habworks/SuperStar1/Enclosure/SuperStar_PCB.stl

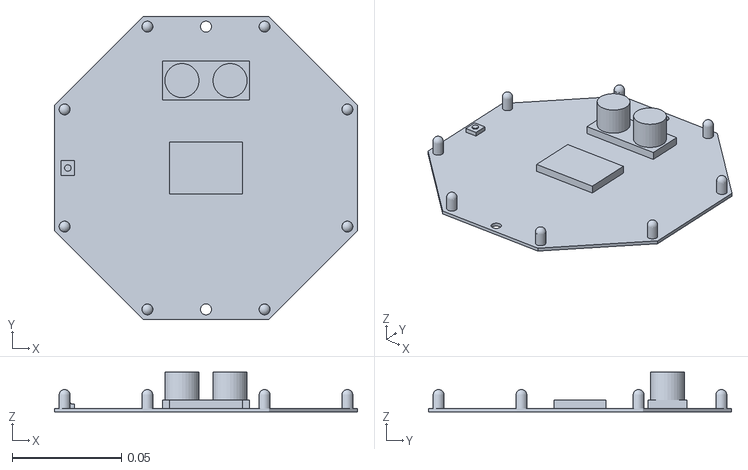
[picture p1: CAD file, 2020-10-04]
Enclosure/SuperStar_PCB.stl
0.139 x 0.139 x 0.0181
