habworks/SuperStar1/Enclosure/EnclosureBase3.stl

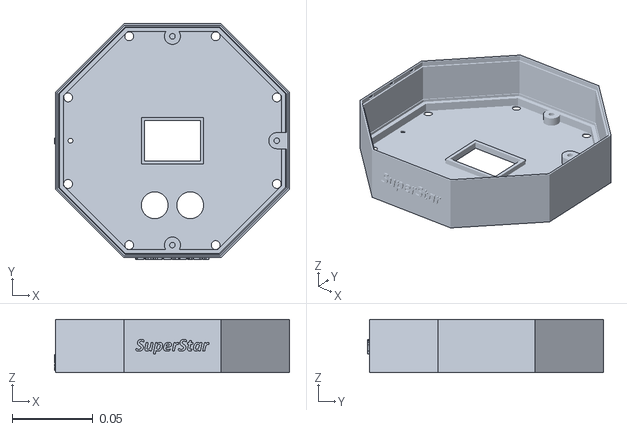
[picture p2: CAD file, 2020-10-04]
Enclosure/EnclosureBase3.stl
0.146 x 0.146 x 0.033
