habworks/SuperStar1/Enclosure/EnclosureDoor2.stl

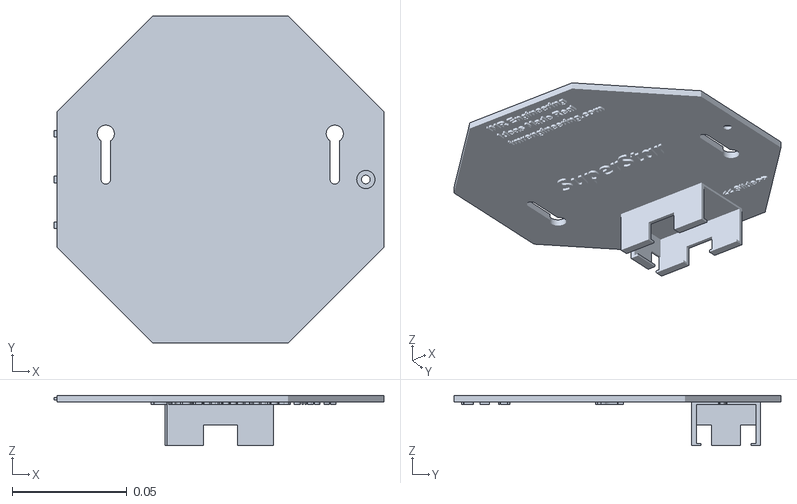
[picture p3: CAD file, 2020-10-04]
Enclosure/EnclosureDoor2.stl
0.144 x 0.143 x 0.022
