habworks/SuperStar1/(list of files, cad)

Other CAD files:
Enclosure/EnclosureBase3.blend
Enclosure/EnclosureDoor2.blend
Enclosure/SuperStar_PCB2.blend
