habworks/SuperStar1/Schematic/SUPERSTAR_SCH.PDF

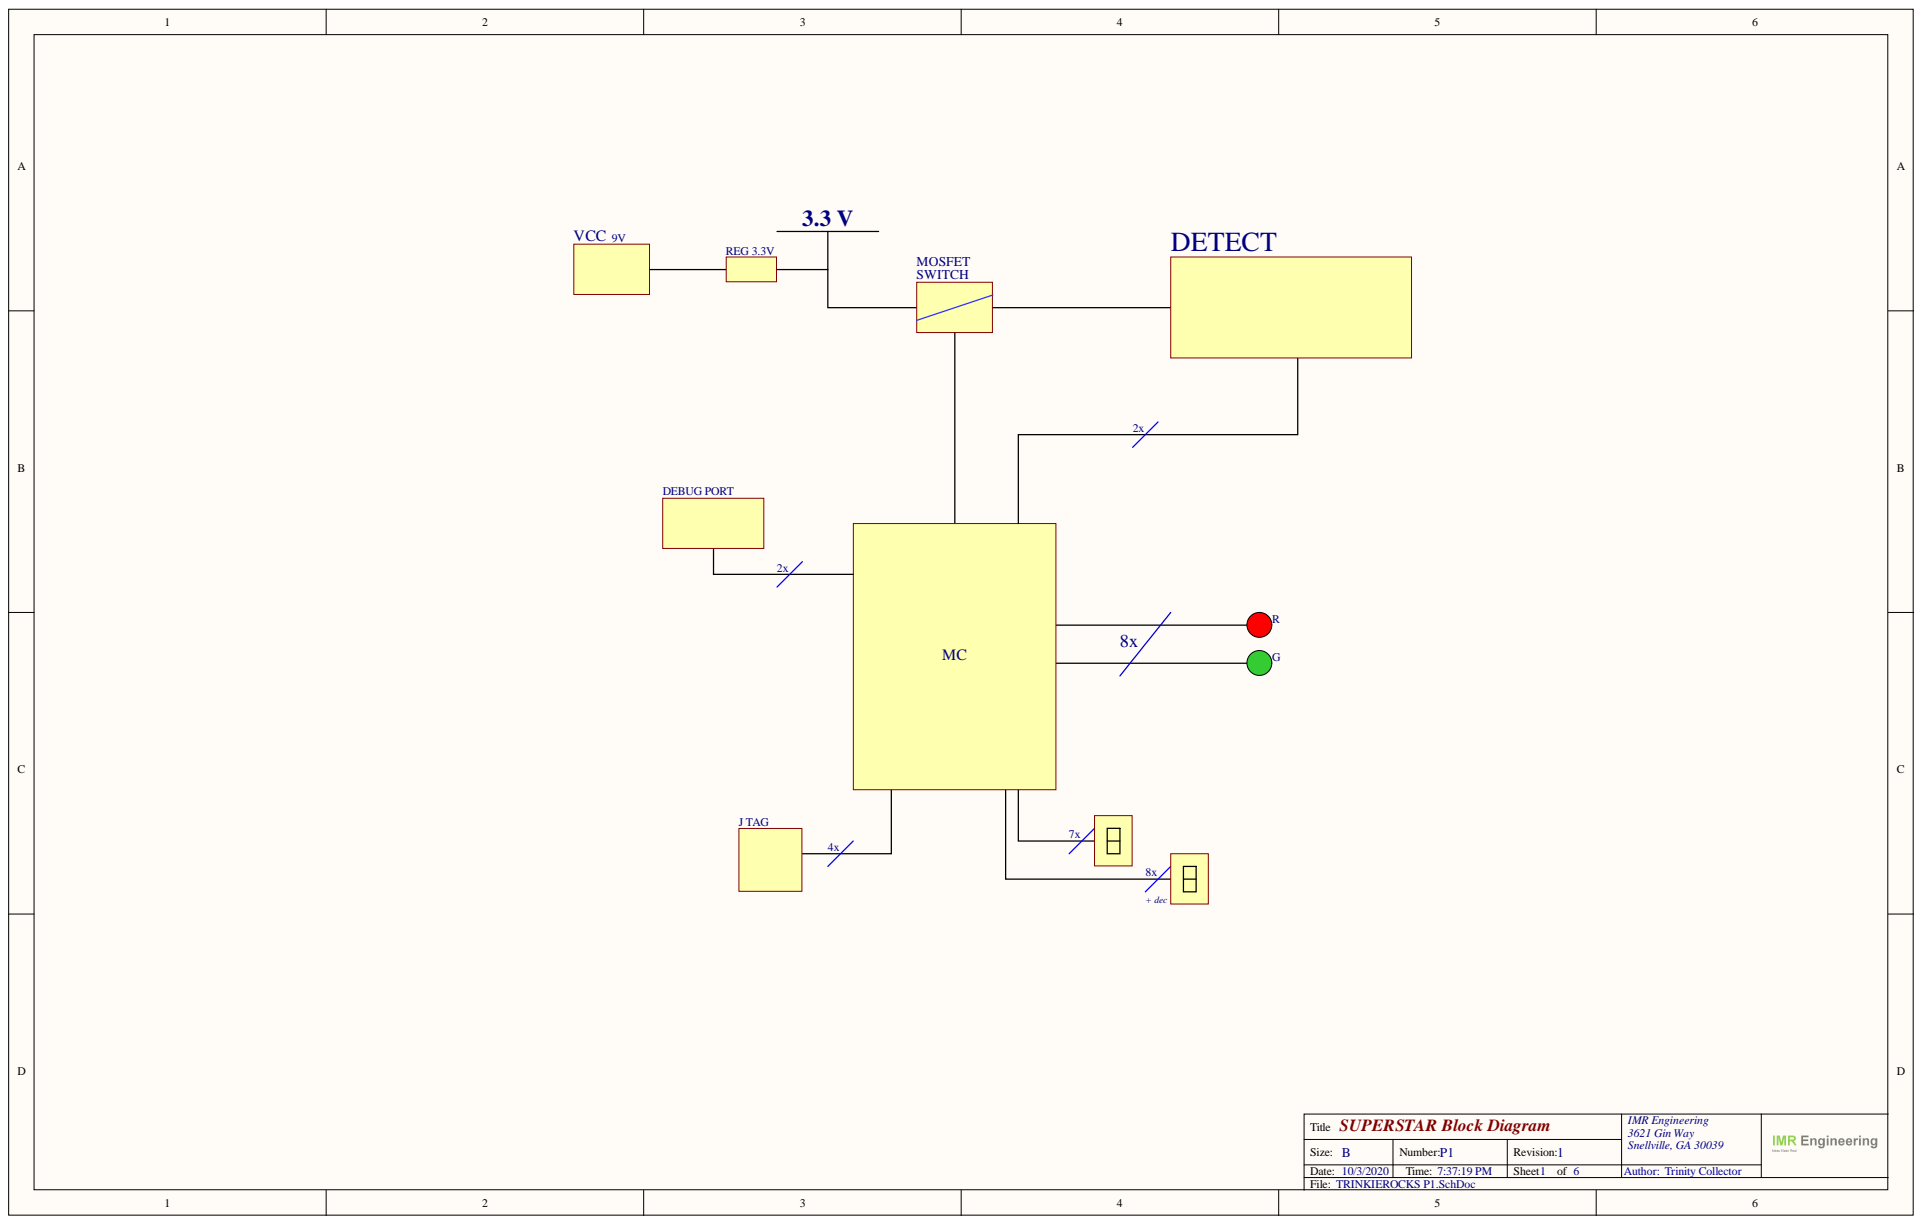
[picture p4: page 1]
VCC 9V; MOSFET 3.3V; DETECT; DEBUG PORT; J TAG; + dec

Title SUPERSTAR Block Diagram | IMR Engineering 3621 Gin Way Snellville, GA 30039

Size: B | Number: P1 | Revision: 1
Date: 10/3/2020 | Time: 7:37:19 PM | Sheet 1 of 6 | Author: Trinity Collector
File: TRINKIEROCKS P1.SchDoc

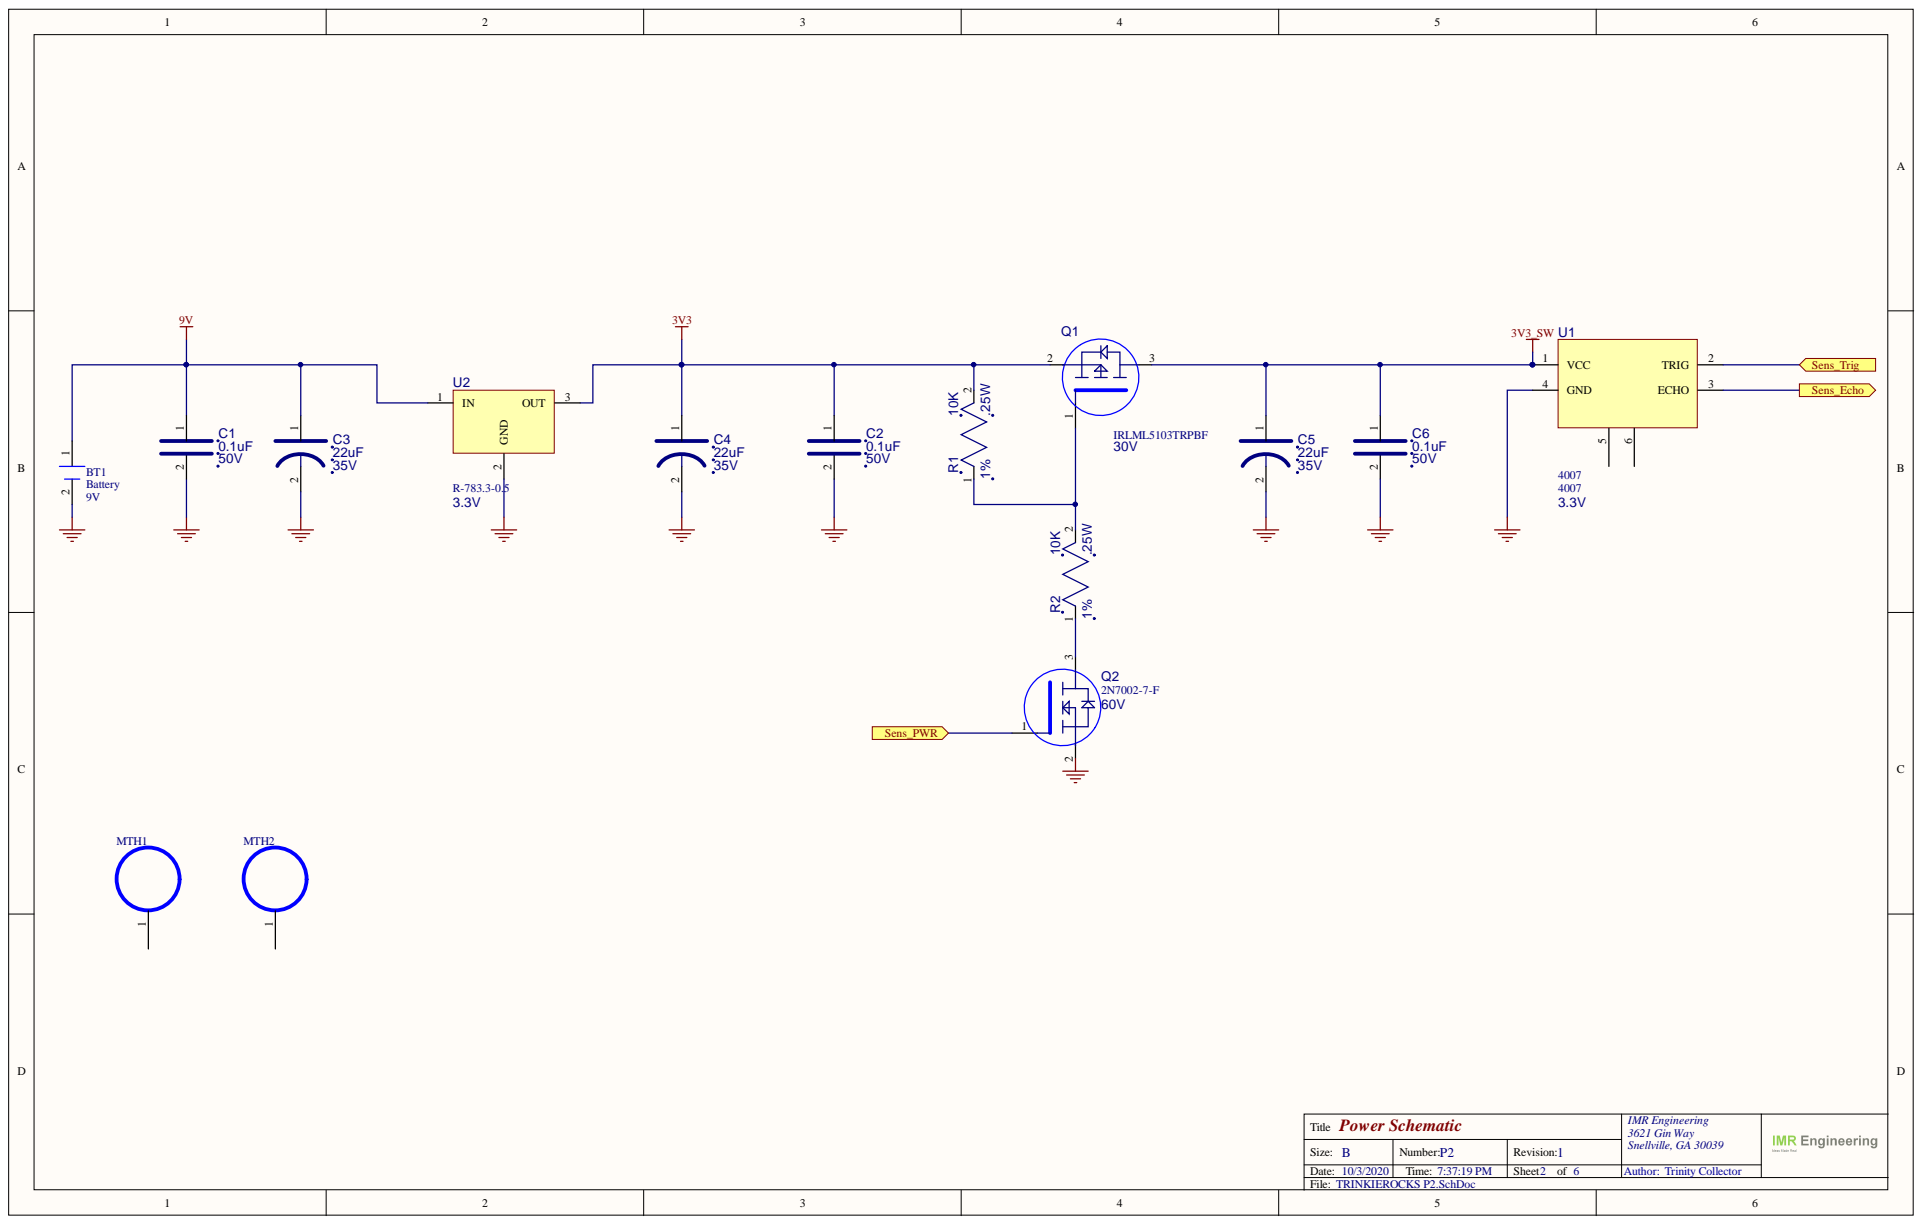
[picture p5: page 2]

Ti tl e Po wer Schem atic | IMR Engineer ing 3621 G in Way Snel lvi l le, GA 30039

Size: B | Number : P2 | Revi s ion: 1
Date: 10/3/2020 | Ti me: 7:37:19 PM | Sheet 2 of 6 | Author : Tr ini ty Col lector
Fi le: T R I N KI E R O C KS P2.SchDoc

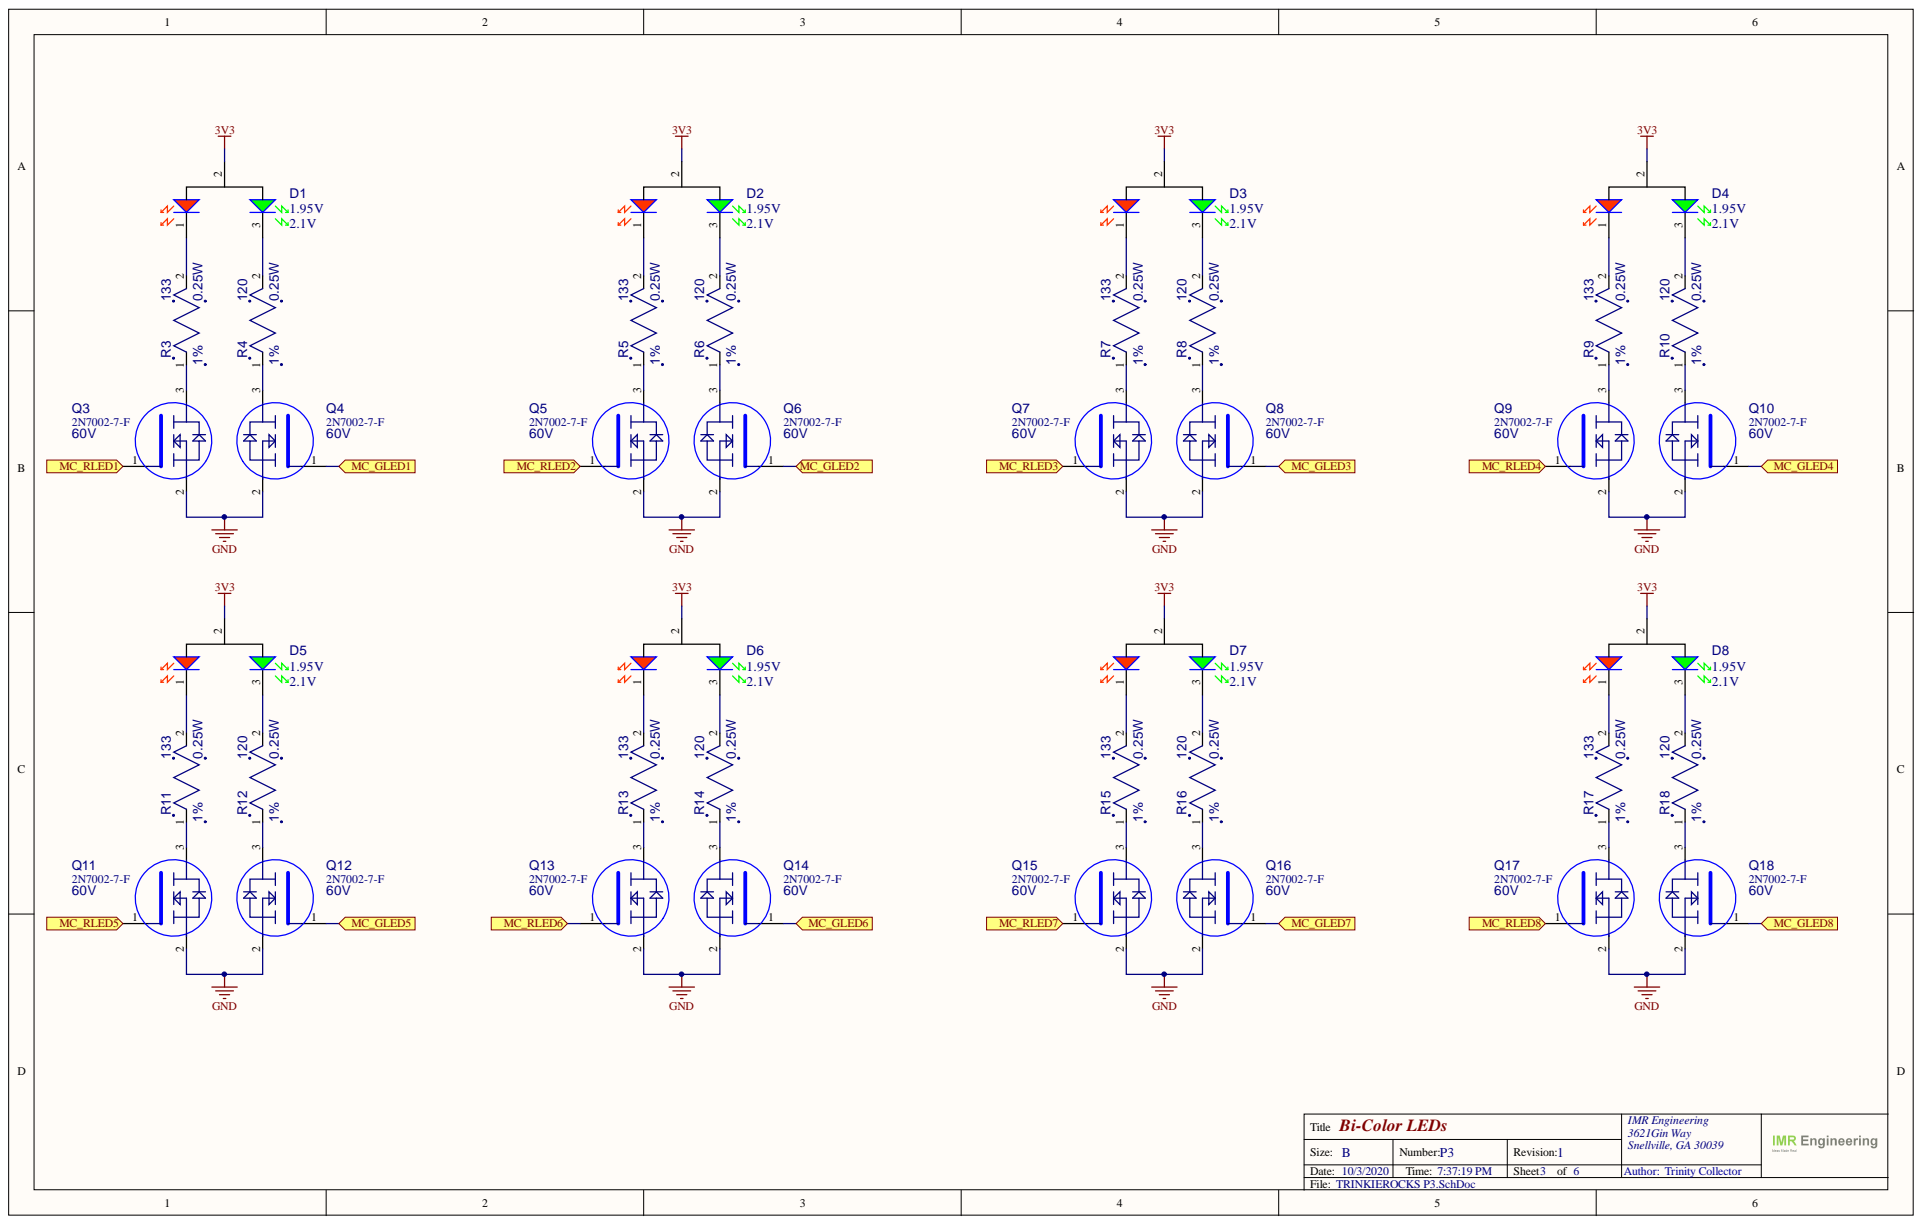
[picture p6: page 3]

Title Bi-Color LEDs | IMR Engineering 3621Gin Way Snellville, GA 30039

Size: B | Number: P3 | Revision: 1
Date: 10/3/2020 | Time: 7:37:19 PM | Sheet 3 of 6 | Author: Trinity Collector
File: TRINKIEROCKS P3.SchDoc

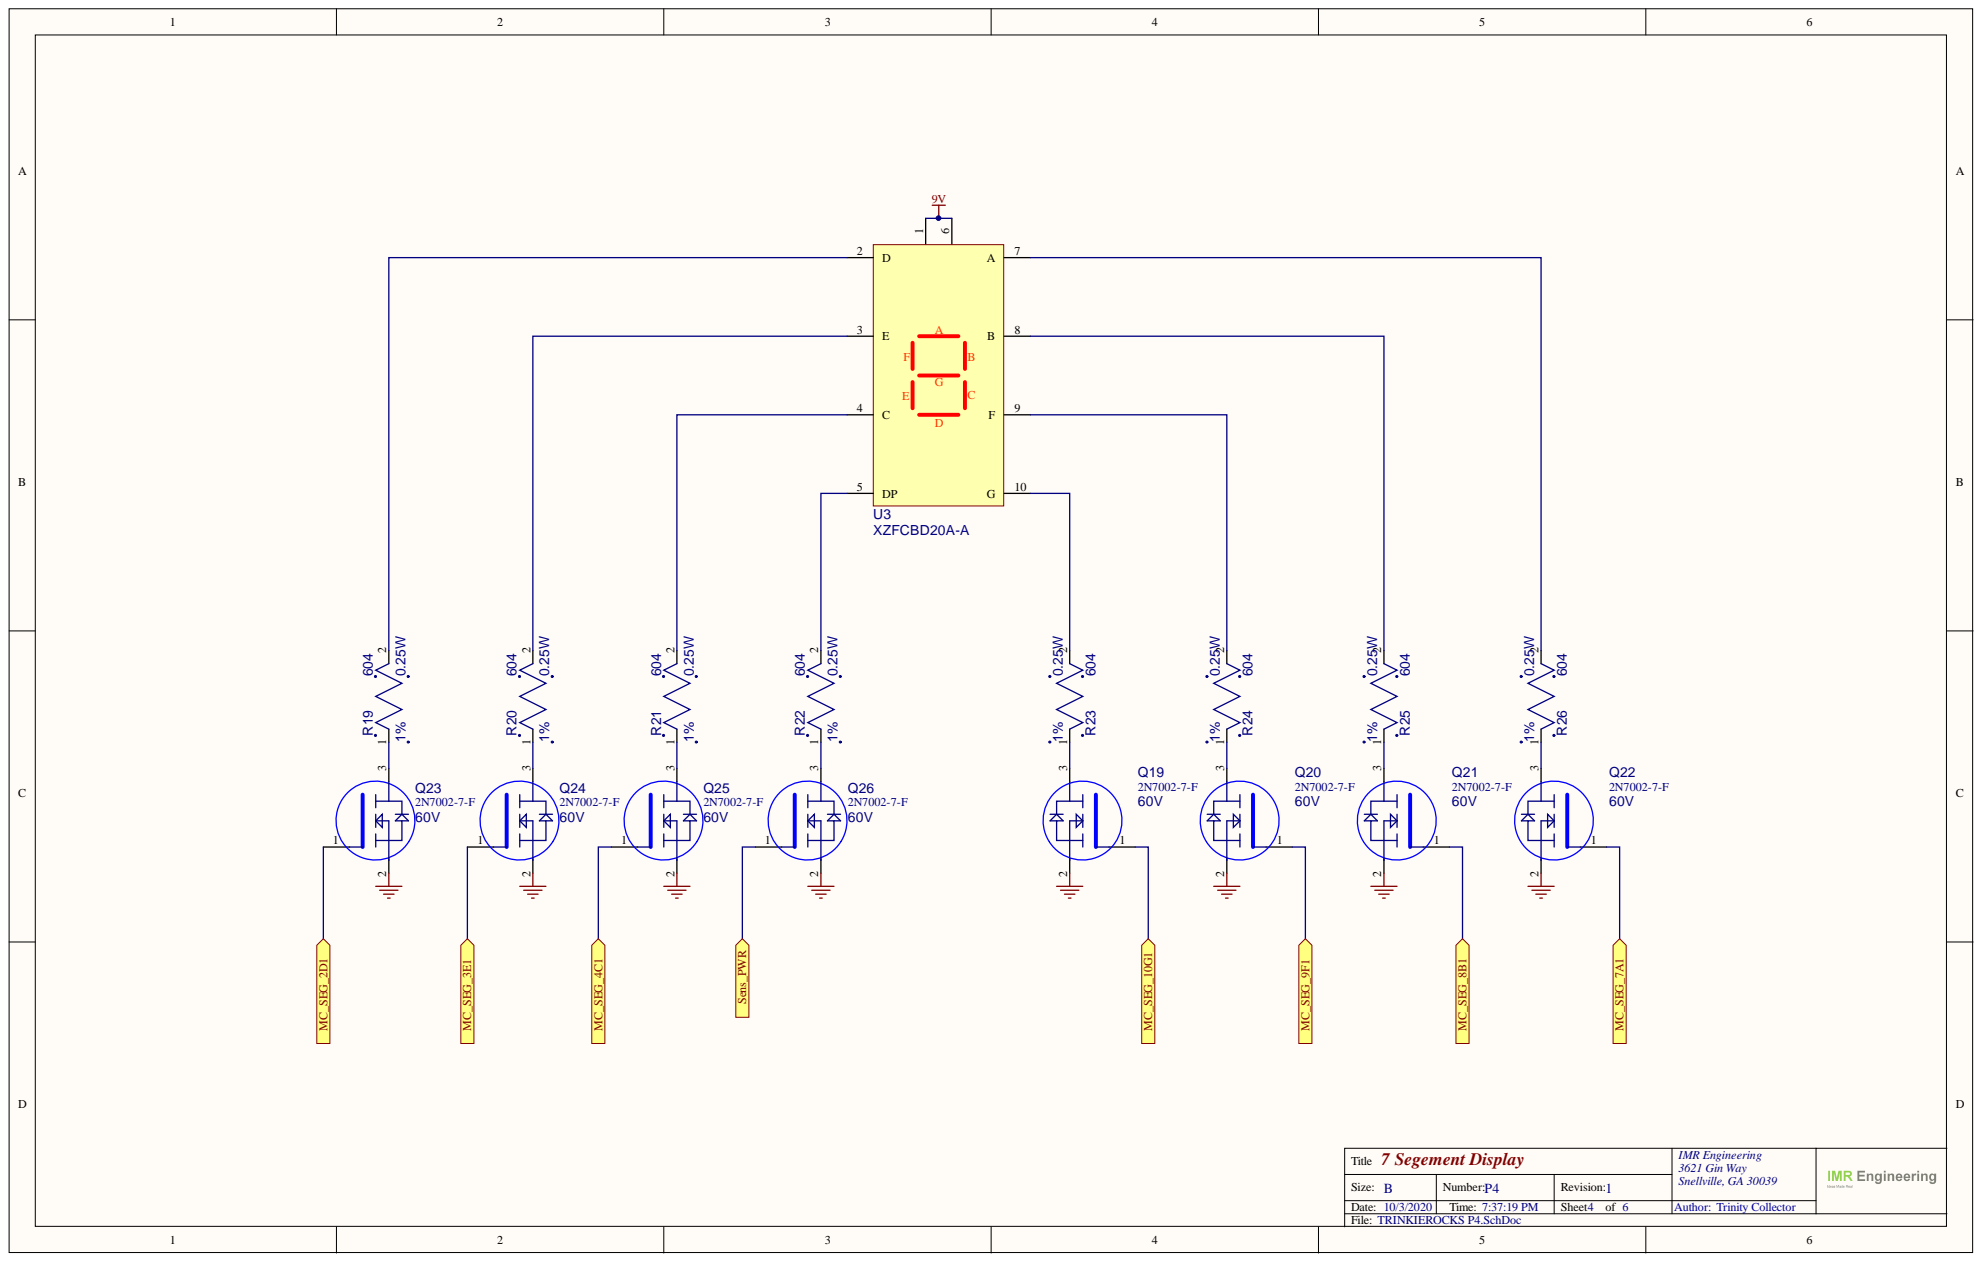
[picture p7: page 4]

Title 7 Segement Display | IMR Engineering 3621 Gin Way Snellville, GA 30039

Size: B | Number: P4 | Revision: 1
Date: 10/3/2020 | Time: 7:37:19 PM | Sheet 4 of 6 | Author: Trinity Collector
File: TRINKIEROCKS P4.SchDoc

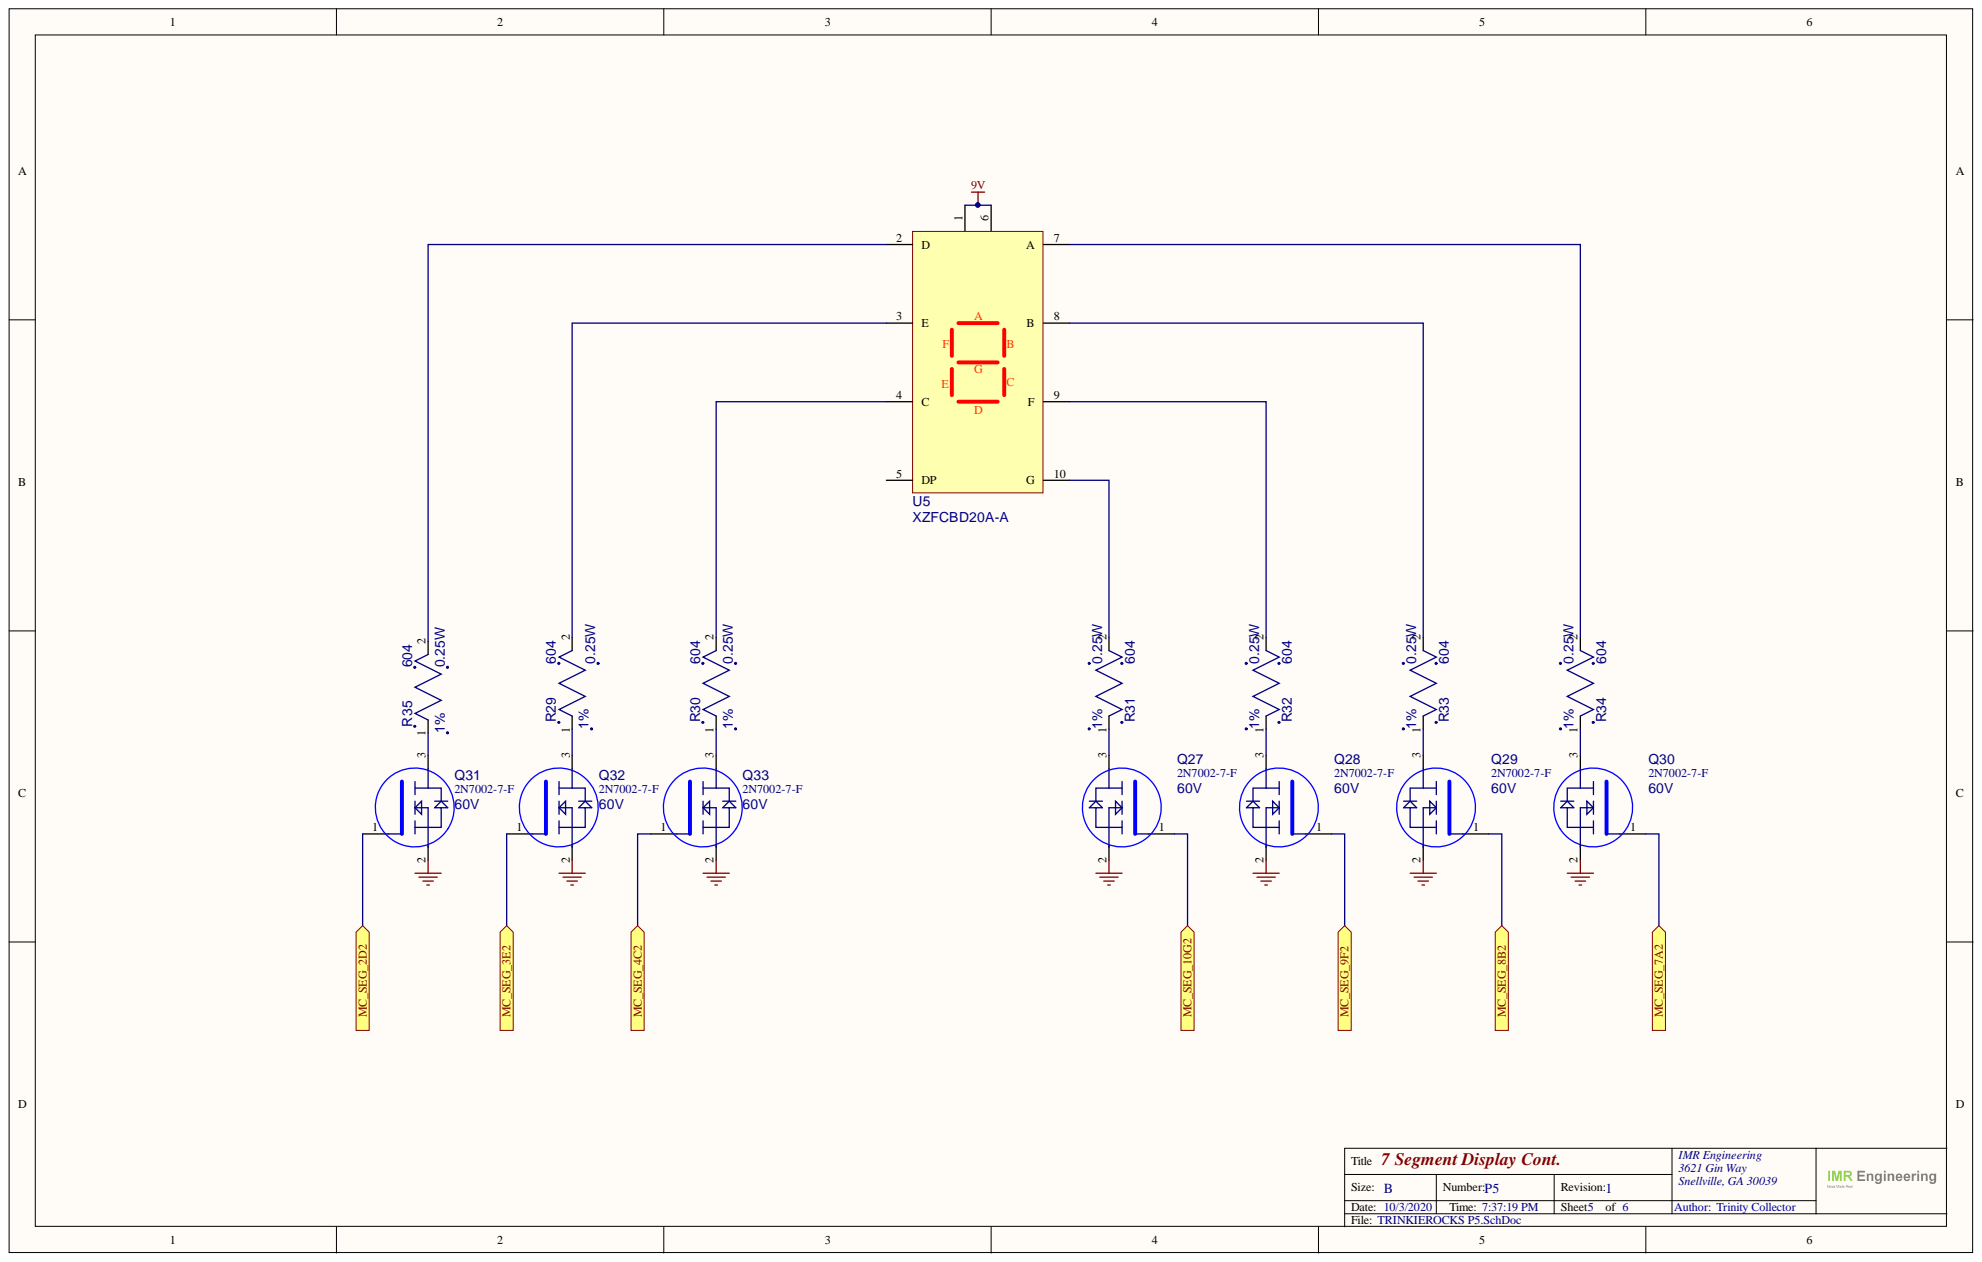
[picture p8: page 5]

Title 7 Segment Display Cont. | IMR Engineering 3621 Gin Way Snellville, GA 30039

Size: B | Number: P5 | Revision: 1
Date: 10/3/2020 | Time: 7:37:19 PM | Sheet 5 of 6 | Author: Trinity Collector
File: TRINKIEROCKS P5.SchDoc

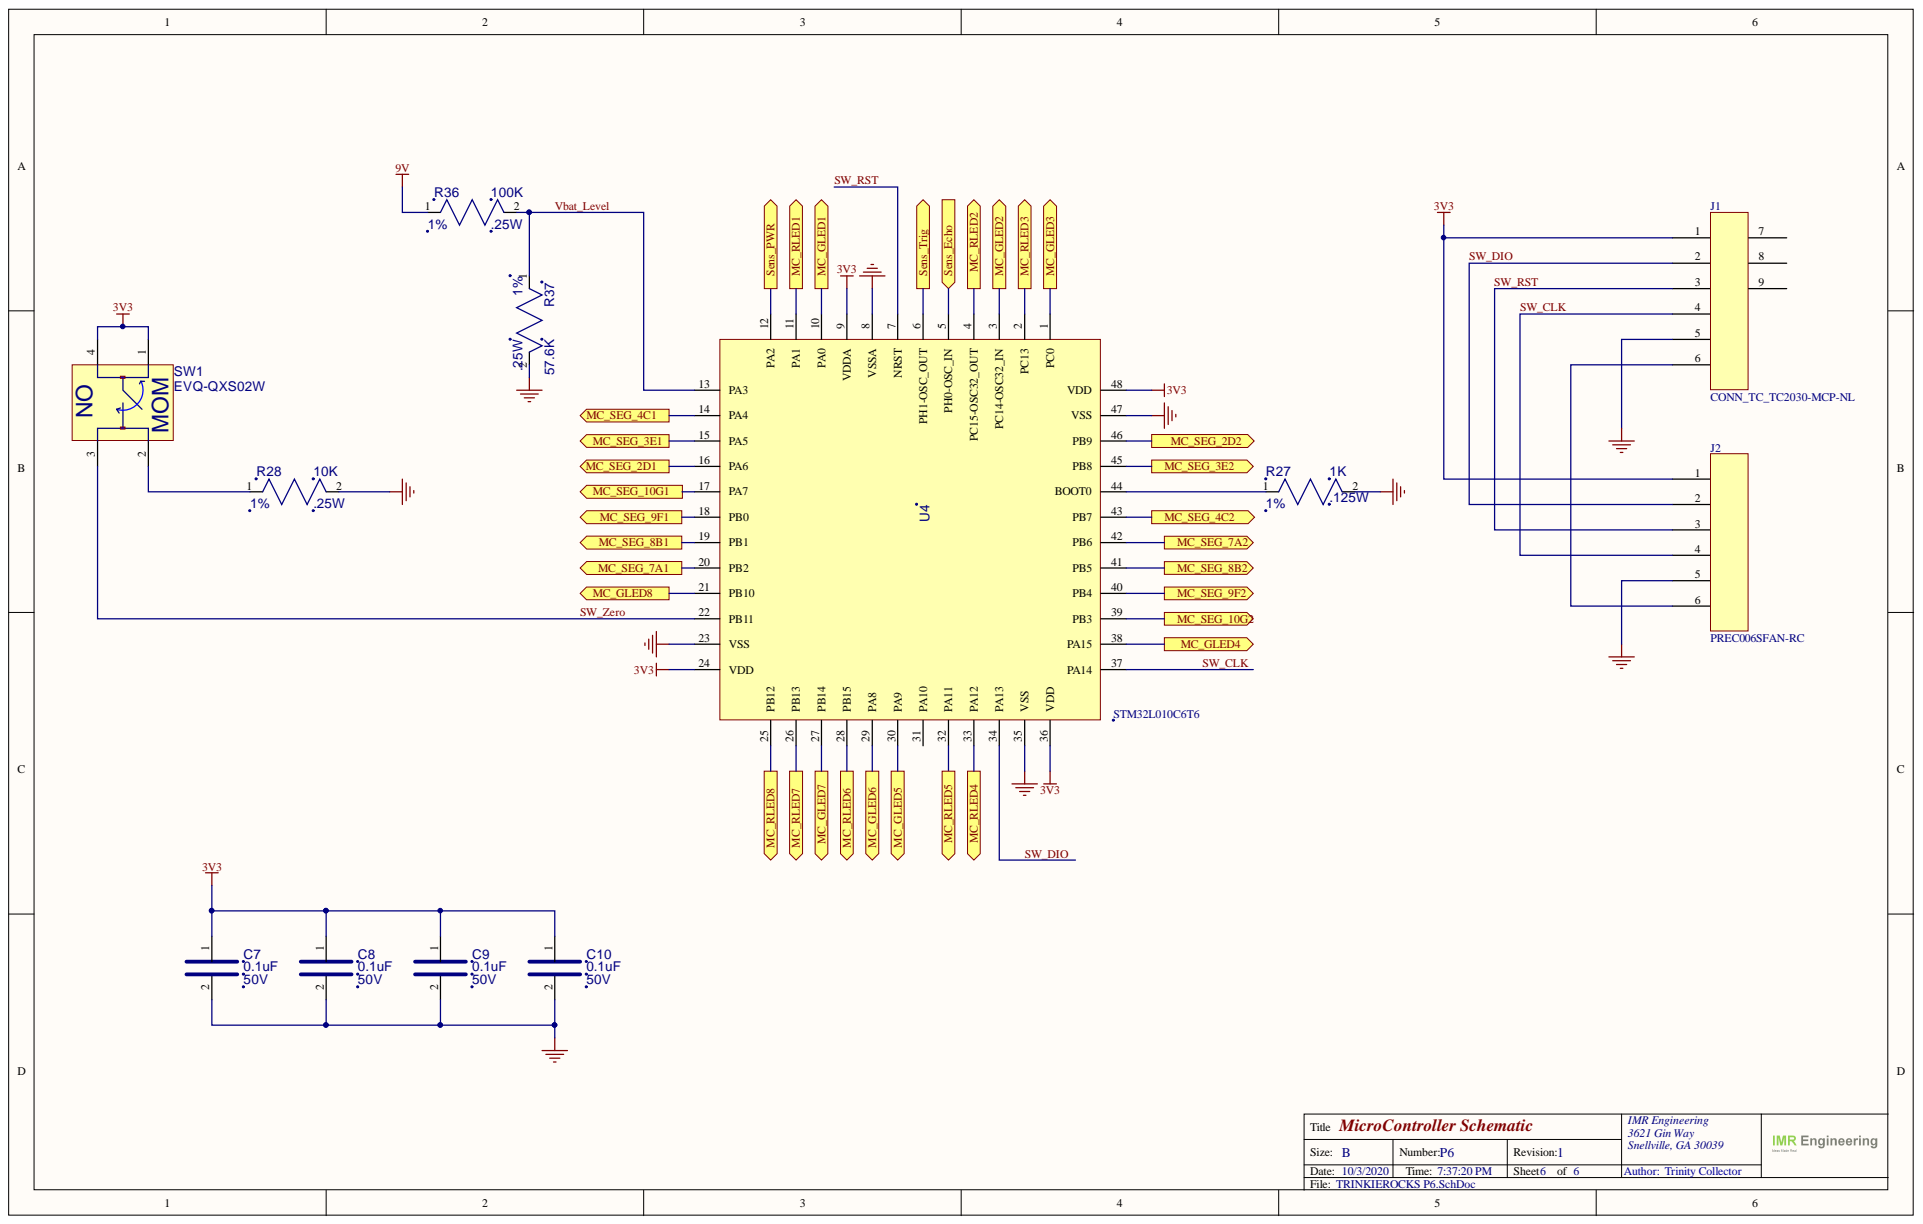
[picture p9: page 6]
OUT 4; OUT 6; NRST 7; VSSA 8; VDDA 9; VSS 23; VDD 24; VSS 35; VDD 36; VSS; 47 VDD

SW_RST | 654321

Ti tl e Micro C ontroller Schem atic | IMR Engineer ing 3621 G in Way Snel lvi l le, GA 30039

Size: B | Number : P6 | Revi s ion: 1
Date: 10/3/2020 | Ti me: 7:37:20 PM | Sheet 6 of 6 | Author : Tr ini ty Col lector
Fi le: T R I N KI E R O C KS P6.SchDoc
