habworks/SuperStar1/PCB/SUPERSTAR_3D.PDF

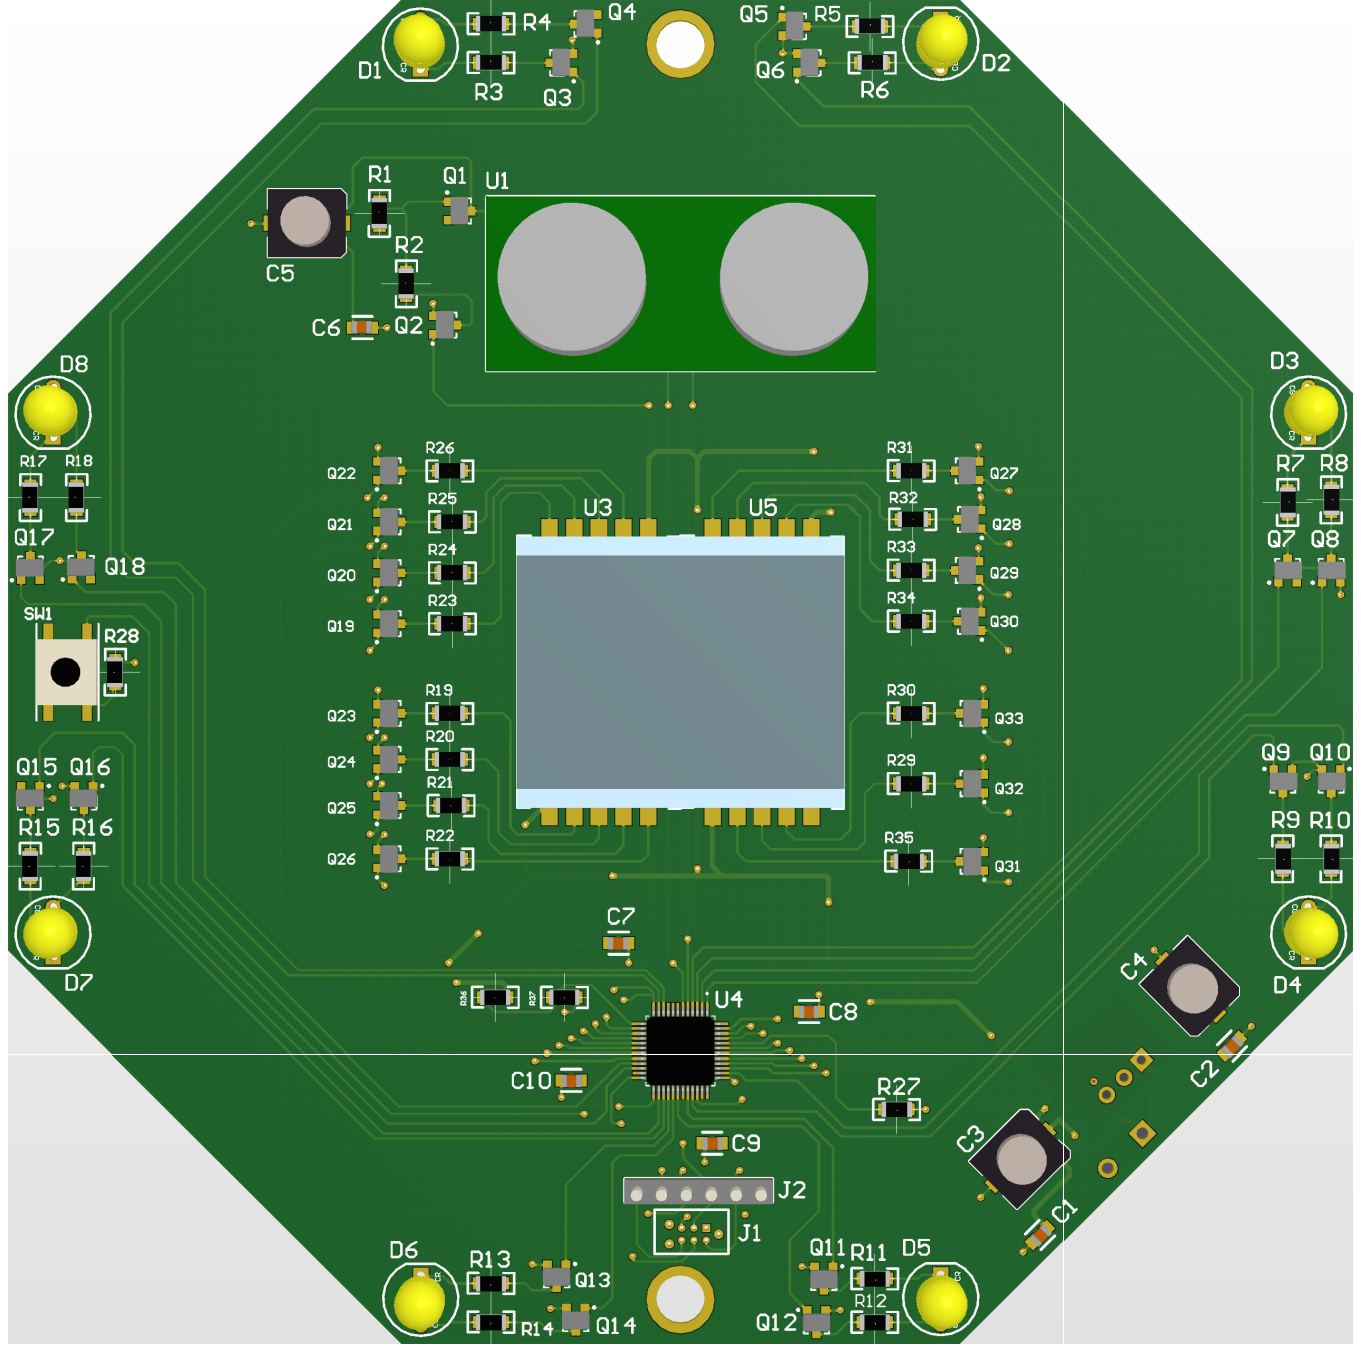
[picture p10: page 1]
