habworks/SuperStar1/SuperStar1/SuperStar1.ioc

Mcu.UserName=STM32L010C6Tx
PA0.GPIO_Label=MC_GLED1
PA0.Signal=GPIO_Output
PA1.GPIO_Label=MC_RLED1
PA1.Signal=GPIO_Output
PA11.GPIO_Label=MC_RLED5
PA11.Signal=GPIO_Output
PA12.GPIO_Label=MC_RLED4
PA12.Signal=GPIO_Output
PA13.GPIO_Label=SW_DIO
PA13.Signal=SYS_SWDIO
PA14.GPIO_Label=SW_CLK
PA14.Signal=SYS_SWCLK
PA15.GPIO_Label=MC_GLED4
PA15.Signal=GPIO_Output
PA2.GPIO_Label=Sens_PWR
PA2.Signal=GPIO_Output
PA3.GPIO_Label=Vbat_Level
PA3.Signal=ADC_IN3
PA4.GPIO_Label=MS_SEG_4C1
PA4.Signal=GPIO_Output
PA5.GPIO_Label=MC_SEG_3E1
PA5.Signal=GPIO_Output
PA6.GPIO_Label=MC_SEG_2D1
PA6.Signal=GPIO_Output
PA7.GPIO_Label=MC_SEG_10G1
PA7.Signal=GPIO_Output
PA8.GPIO_Label=MC_GLED6
PA8.Signal=GPIO_Output
PA9.GPIO_Label=MC_GLED5
PA9.Signal=GPIO_Output
PB0.GPIO_Label=MC_SEG_9F1
PB0.Signal=GPIO_Output
PB1.GPIO_Label=MC_SEG_8B1
PB1.Signal=GPIO_Output
PB10.GPIO_Label=MC_GLED8
PB10.Signal=GPIO_Output
PB11.GPIO_Label=SW_Zero
PB11.Signal=GPXTI11
PB12.GPIO_Label=MC_RLED8
PB12.Signal=GPIO_Output
PB13.GPIO_Label=MC_RLED7
PB13.Signal=GPIO_Output
PB14.GPIO_Label=MC_GLED7
PB14.Signal=GPIO_Output
PB15.GPIO_Label=MC_RLED6
PB15.Signal=GPIO_Output
PB2.GPIO_Label=MC_SEG_7A1
PB2.Signal=GPIO_Output
PB3.GPIO_Label=MC_SEG_10G2
PB3.Signal=GPIO_Output
PB4.GPIO_Label=MC_SEG_9F2
PB4.Signal=GPIO_Output
PB5.GPIO_Label=MC_SEG_8B2
PB5.Signal=GPIO_Output
PB6.GPIO_Label=MC_SEG_7A2
PB6.Signal=GPIO_Output
PB7.GPIO_Label=MC_SEG_4C2
PB7.Signal=GPIO_Output
PB8.GPIO_Label=MC_SEG_3E2
PB8.Signal=GPIO_Output
PB9.GPIO_Label=MC_SEG_2D2
PB9.Signal=GPIO_Output
PC0.GPIO_Label=MC_GLED3
PC0.Signal=GPIO_Output
PC13-ANTI_TAMP.GPIO_Label=MC_RLED3
PC13-ANTI_TAMP.Signal=GPIO_Output
PC14-OSC32_IN.GPIO_Label=MC_GLED2
PC14-OSC32_IN.Signal=GPIO_Output
PC15-OSC32_OUT.GPIO_Label=MC_RLED2
PC15-OSC32_OUT.Signal=GPIO_Output
PH0-OSC_IN.GPIO_Label=Sens_Echo
PH0-OSC_IN.Signal=GPIO_Input
PH1-OSC_OUT.GPIO_Label=Sens_Trig
PH1-OSC_OUT.Signal=GPIO_Output
