habworks/SuperStar1/(commit log)

2020-07-19 Adds the following: 1. Working ADC with calibration in polling module 2. Bug fix for LED2 3. NV Memory read and write 4. Code clean up and commenting
    [BatteryMonitor.c, BatteryMonitor.h, LED_Control.c, LED_Control.h, MainSupport.h, NV_Memory.c, NV_Memory.h]
2020-07-22 First commit of LPTIM timer Changes to git tracking
2020-07-22 Attempt to fix broken project file File not building
    [LED_Control.h]
2020-07-22 Modified define for calibration load
2020-07-22 Attempt to fix problems with project
    [LED_Control.h]
2020-07-25 This check in adds: Working Low Power Timer for Wakeup: Set now to 5ms Working TIM2 Timer for software PWM: Set now to 100us Working TIM21 Timer for 1ms blocking delay function: Set now to 1ms
2020-07-26 This commit has somewhat working ImplementSleep But there are issues: Sleep is not sleeping in uA range Changes made to CubeMX timers for TIM2, LPTIM, and clock map
    [MainSupport.h, NV_Memory.c, NV_Memory.h, SuperStar1.ioc, Timers.c]
2020-07-29 Work from Trinks: Added to LED_Control: segONE_OFF, segTENTH_OFF displayNumONE, displayNumTENTH displayErrorCode ledFLASH_test_1
2020-08-01 Many changes to make low power sleep work better This looks like significant progress Sleep here about 350uA with ST Debugger removed
2020-08-09 This checkin has work on the Sleep completed or as good as it is going to get for now. May attempt to work on this later or on going. It also adds Work on calibrating the LPTIM
2020-08-31 This is an update from Trinks. It includes DistanceSensor Rolling Average of Distance Rolling Average of Battery Voltage Real Number Display
2020-09-17 Changes made by TrinksInc Filter added for battery voltage Filter added for Distance Calculating distance other changes and review
2020-10-03 Added Hardware of: PCB Schematic Enclosure Made some firmware additions to start up display
    [EnclosureBase3.blend, EnclosureBase3.stl, EnclosureDoor2.blend, EnclosureDoor2.stl, SuperStar_PCB.stl, SuperStar_PCB2.blend]
2020-10-07 The power up / reset startup display is completed.
    [LED_Control.c, LED_Control.h]
2020-10-15 More updates and added power on sequence Added more to build the applicaton in progress
